FROM-THE-EARTH/NSE2020_10th/EAGLE/projects/NSE2020_1.brd

## EAGLE design EAGLE/projects/NSE2020_1.brd (2020-06-14)

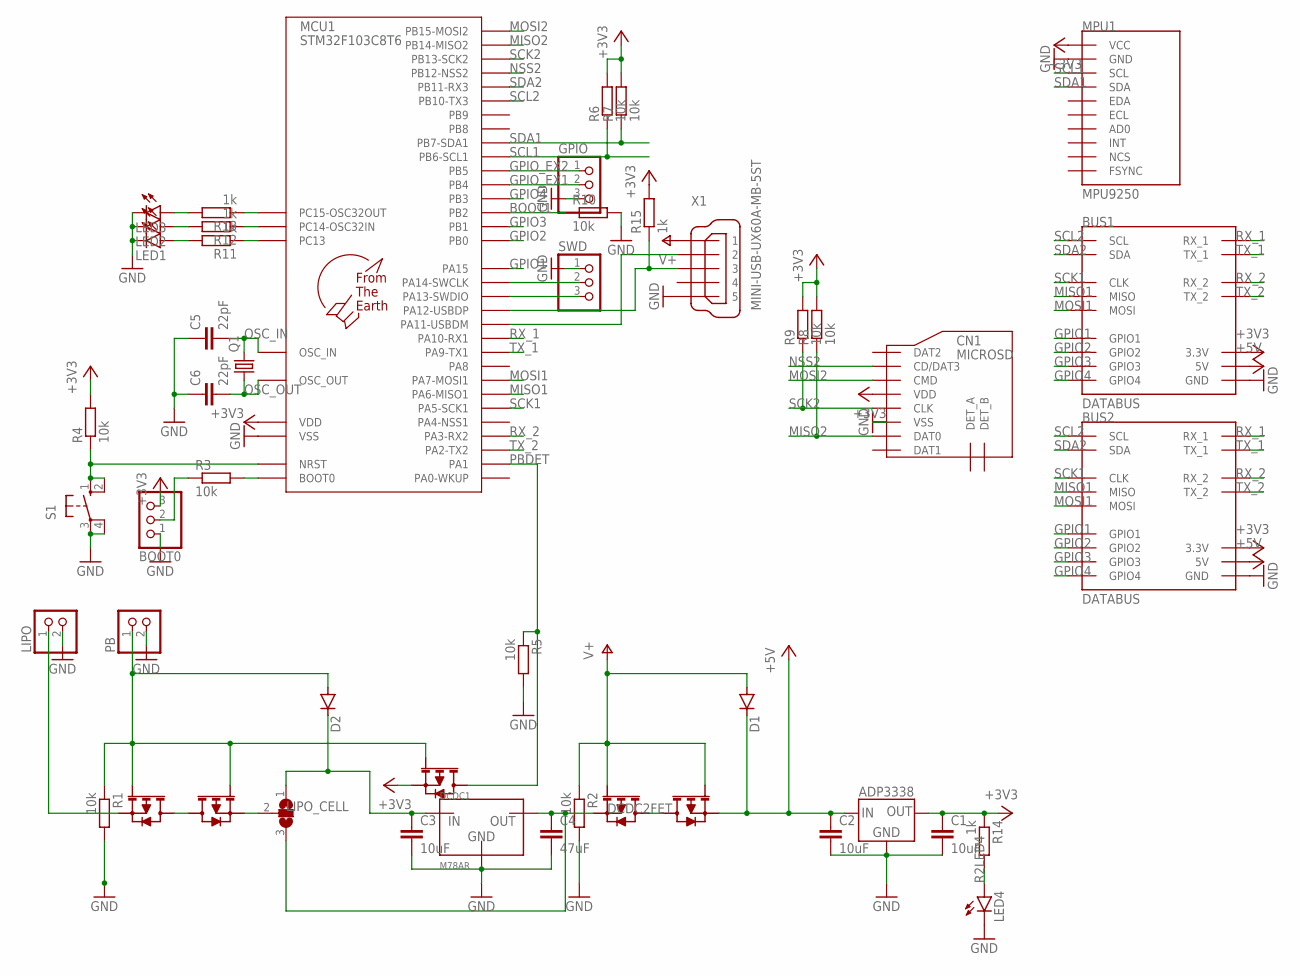
[picture p11: schematic NSE2020_1.sch]

Parts:
BOOT0: PINHD-1X3; 1X03
BUS1, BUS2: DATABUS; 8X2
C1, C2, C3: 10uF; C2012
C4: 47uF; C2012
C5, C6: 22pF; C2012
CN1: MICROSD; DM3AT
D1, D2: DIODE-SOD123; SOD123
DCDC1: M78AR
FET1, FET2, FET3, FET4, FET5: 2SJ681
GPIO: PINHD-1X3; 1X03
IC1: ADP3338-3.3; SOT-223
LED1, LED2, LED3, LED4: LEDSML0805; SML0805
LIPO: PINHD-1X2; 1X02
LIPO_CELL: SJ2W; SJ_2
MCU1: STM32F103C8T6; LQFP48
MPU1: MPU9250; GY-9250
PB: PINHD-1X2; 1X02
Q1: CRYSTALHC49S; HC49/S
R1, R2, R3, R4, R5, R6, R7, R8, R9, R10: 10k; M2012
R11, R12, R13, R14, R15: 1k; M2012
S1: 10-XX; B3F-10XX
SWD: PINHD-1X3; 1X03
U$1: F.T.E.LOGO; LOGO
X1: MINI-USB-UX60A-MB-5ST; UX60A-MB-5ST

Connections:
+3V3: BOOT0.3, BUS1.P6 (3.3V), BUS2.P6 (3.3V), C1.1, CN1.VDD, FET5.P$3, IC1.1 (OUT), IC1.2 (OUT), MCU1.1 (VDD), MCU1.9 (VDD), MCU1.24 (VDD), MCU1.36 (VDD), MCU1.48 (VDD), MPU1.P1 (VCC), R4.2, R6.2, R7.2, R8.2, R9.2, R14.1, R15.2
+5V: BUS1.P7 (5V), BUS2.P7 (5V), C2.1, D1.C, FET4.P$3, IC1.3 (IN)
BAT2DCDC: C3.1, D2.C, DCDC1.P1 (IN), LIPO_CELL.1
BOOT0: BOOT0.2, R3.1
BOOT0_R: MCU1.44 (BOOT0), R3.2
BOOT1: MCU1.20 (PB2), R10.1
DCDC2FET: C4.1, DCDC1.P3 (OUT), FET3.P$3, LIPO_CELL.3
DM: MCU1.32 (PA11-USBDM), X1.2
DP: MCU1.33 (PA12-USBDP), R15.1, X1.3
FET2FET: FET3.P$2, FET3.P$4, FET4.P$2, FET4.P$4
FET2JUMP: FET2.P$3, LIPO_CELL.2
GND: BOOT0.1, BUS1.P11 (GND), BUS2.P11 (GND), C1.2, C2.2, C3.2, C4.2, C5.1, C6.1, CN1.VSS, DCDC1.P2 (GND), GPIO.3, IC1.4 (GND), LED1.C, LED2.C, LED3.C, LED4.C, LIPO.2, MCU1.8 (VSS), MCU1.23 (VSS), MCU1.35 (VSS), MCU1.47 (VSS), MPU1.P2 (GND), PB.2, R1.2, R2.2, R5.2, R10.2, S1.3, S1.4 (P1), SWD.1, X1.5
GPIO1: BUS1.P3 (GPIO1), BUS2.P3 (GPIO1), MCU1.38 (PA15)
GPIO2: BUS1.P10 (GPIO2), BUS2.P10 (GPIO2), MCU1.18 (PB0)
GPIO3: BUS1.P14 (GPIO3), BUS2.P14 (GPIO3), MCU1.19 (PB1)
GPIO4: BUS1.P15 (GPIO4), BUS2.P15 (GPIO4), MCU1.39 (PB3)
GPIO_EX1: GPIO.2, MCU1.40 (PB4)
GPIO_EX2: GPIO.1, MCU1.41 (PB5)
IO2R1: MCU1.2 (PC13), R11.1
IO2R2: MCU1.3 (PC14-OSC32IN), R12.1
IO2R3: MCU1.4 (PC15-OSC32OUT), R13.1
LIPOIN: FET1.P$3, LIPO.1
LIPO_FET2FET: FET1.P$2, FET1.P$4, FET2.P$2, FET2.P$4
MISO1: BUS1.P12 (MISO), BUS2.P12 (MISO), MCU1.16 (PA6-MISO1)
MISO2: CN1.DAT0, MCU1.27 (PB14-MISO2), R8.1
MOSI1: BUS1.P2 (MOSI), BUS2.P2 (MOSI), MCU1.17 (PA7-MOSI1)
MOSI2: CN1.CMD, MCU1.28 (PB15-MOSI2)
NRST: MCU1.7 (NRST), R4.1, S1.1 (S), S1.2 (S1)
NSS2: CN1.CD/DAT3, MCU1.25 (PB12-NSS2)
OSC_IN: C5.2, MCU1.5 (OSC_IN), Q1.2
OSC_OUT: C6.2, MCU1.6 (OSC_OUT), Q1.1
PBDET: FET5.P$2, FET5.P$4, MCU1.11 (PA1), R5.1
PBIN: D2.A, FET1.P$1, FET2.P$1, FET5.P$1, PB.1, R1.1
R2LED1: LED1.A, R11.2
R2LED2: LED2.A, R12.2
R2LED3: LED3.A, R13.2
R2LED4: LED4.A, R14.2
RX_1: BUS1.P4 (RX_1), BUS2.P4 (RX_1), MCU1.31 (PA10-RX1)
RX_2: BUS1.P9 (RX_2), BUS2.P9 (RX_2), MCU1.13 (PA3-RX2)
SCK1: BUS1.P1 (CLK), BUS2.P1 (CLK), MCU1.15 (PA5-SCK1)
SCK2: CN1.CLK, MCU1.26 (PB13-SCK2), R9.1
SCL1: MCU1.42 (PB6-SCL1), MPU1.P3 (SCL), R6.1
SCL2: BUS1.P0 (SCL), BUS2.P0 (SCL), MCU1.21 (PB10-TX3)
SDA1: MCU1.43 (PB7-SDA1), MPU1.P4 (SDA), R7.1
SDA2: BUS1.P13 (SDA), BUS2.P13 (SDA), MCU1.22 (PB11-RX3)
SWCLK: MCU1.37 (PA14-SWCLK), SWD.2
SWDIO: MCU1.34 (PA13-SWDIO), SWD.3
TX_1: BUS1.P5 (TX_1), BUS2.P5 (TX_1), MCU1.30 (PA9-TX1)
TX_2: BUS1.P8 (TX_2), BUS2.P8 (TX_2), MCU1.12 (PA2-TX2)
V+: D1.A, FET3.P$1, FET4.P$1, R2.1, X1.1

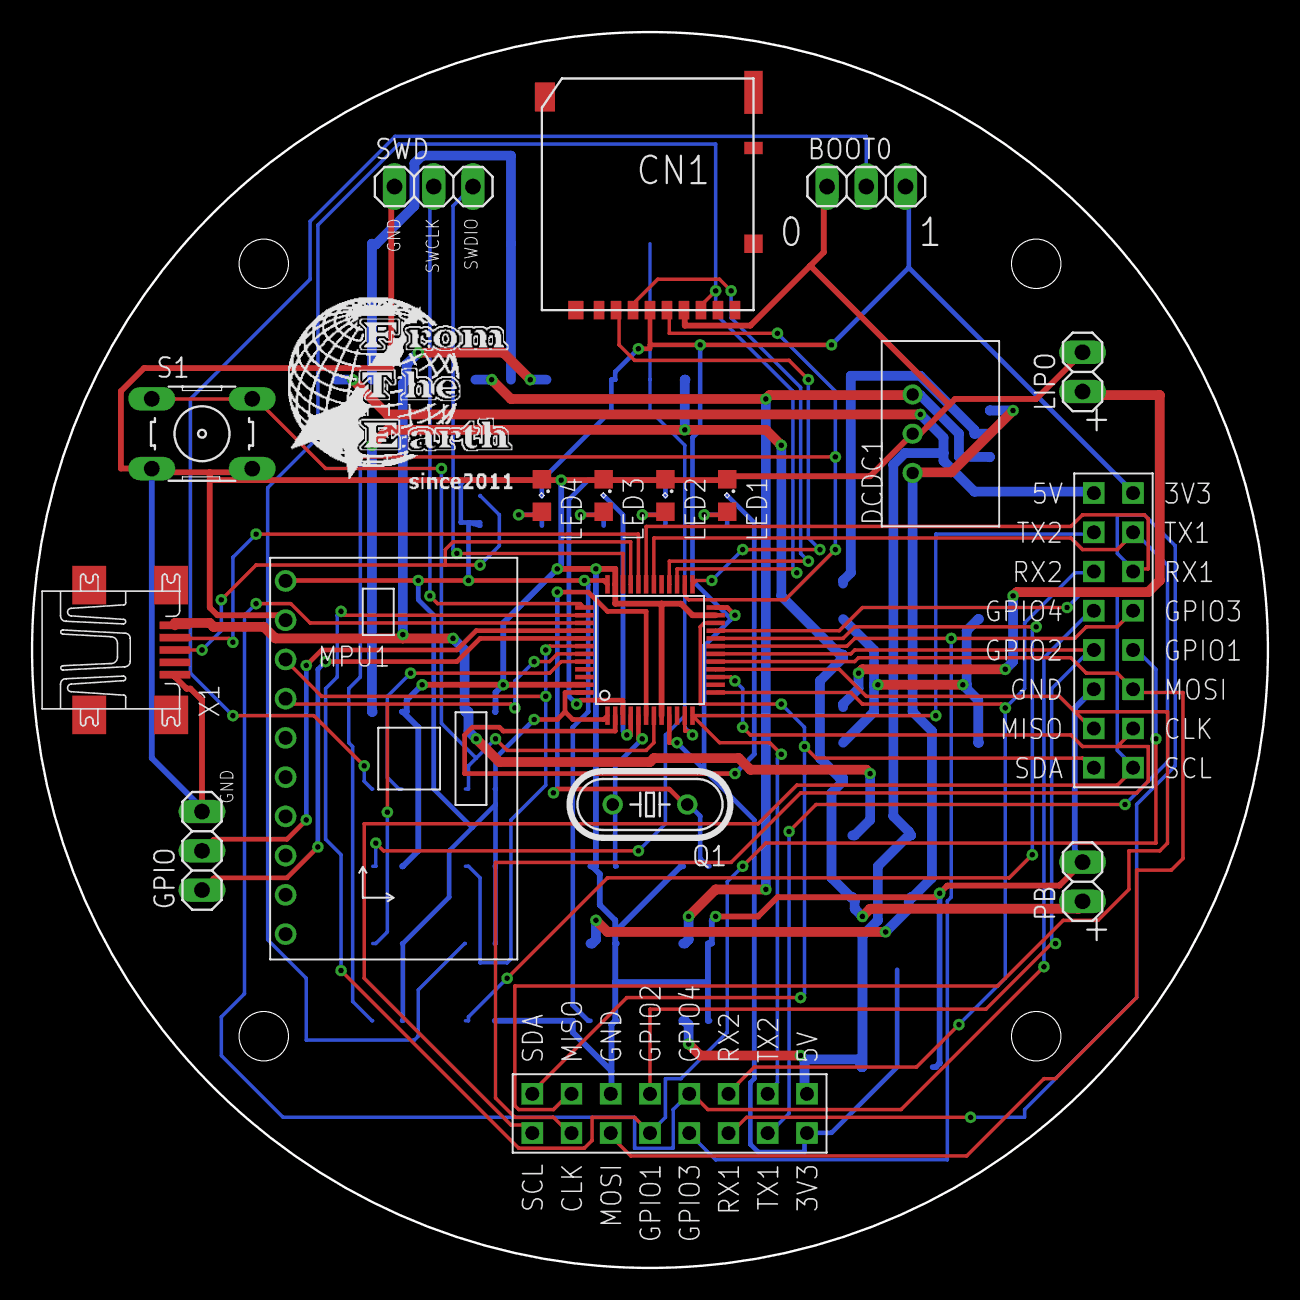
[picture p12: board NSE2020_1.brd from above]

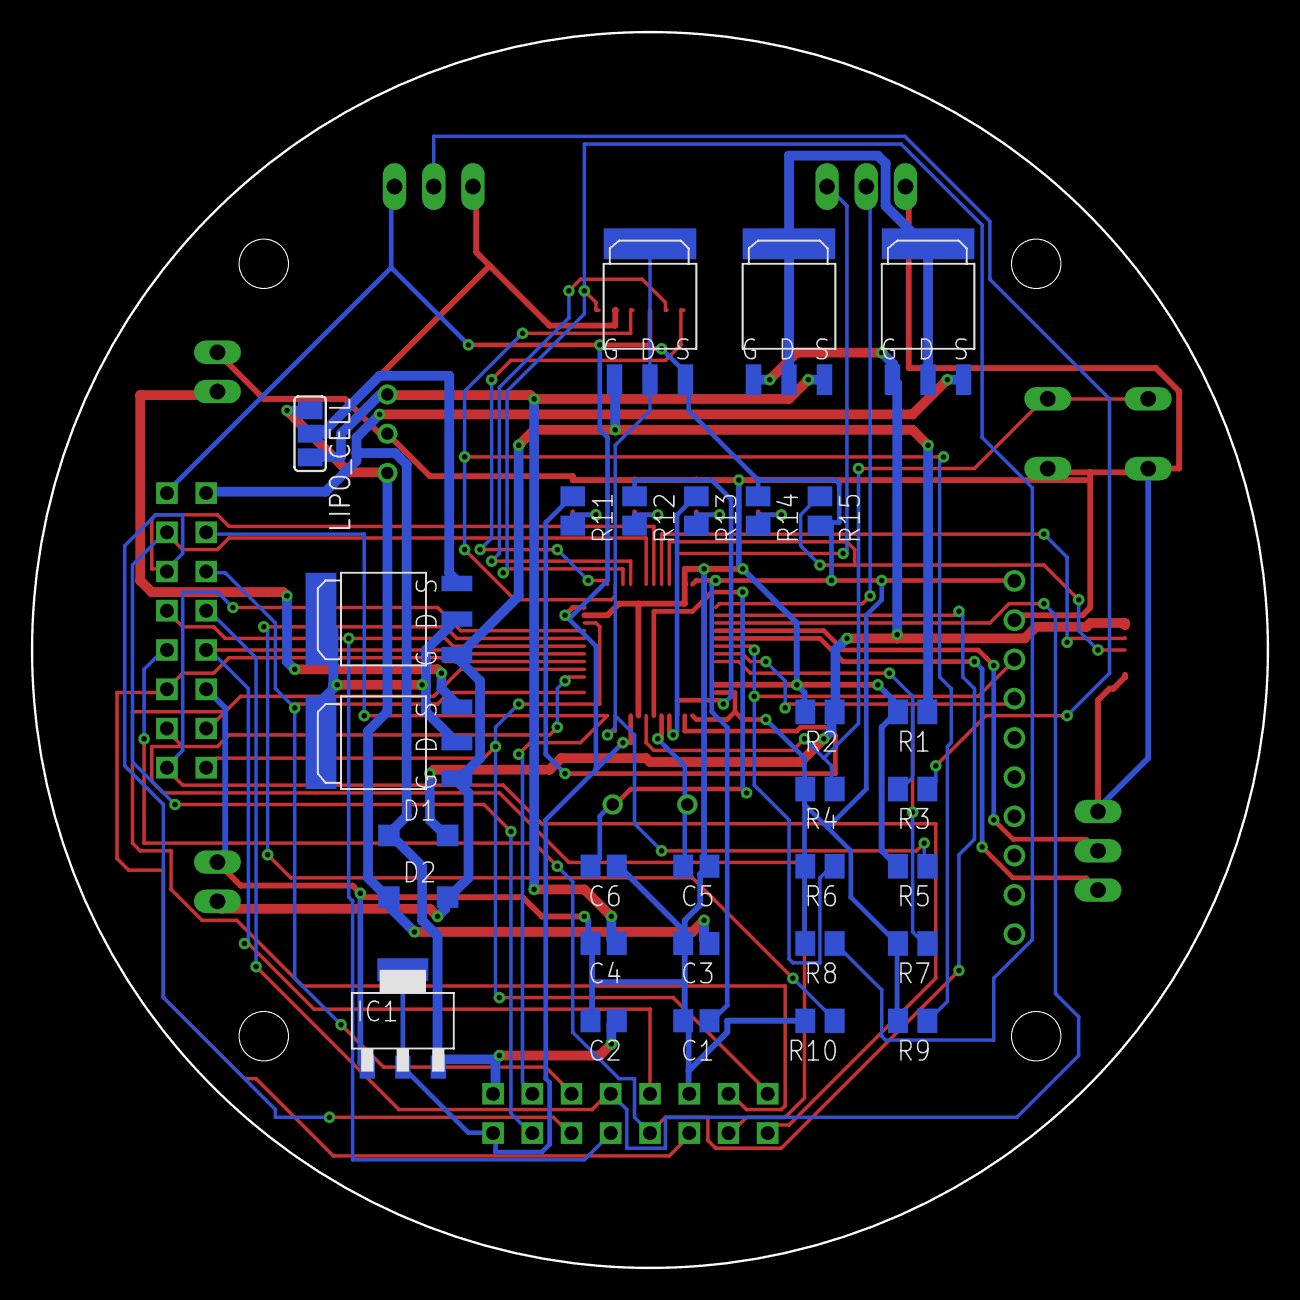
[picture p13: board NSE2020_1.brd from below]

Board: 2 copper layers, 80.0 x 80.0 mm, 49 parts (30 on the bottom side), 50 nets.
