FROM-THE-EARTH/NSE2020_10th/EAGLE/projects/NSE2020_2.brd

## EAGLE design EAGLE/projects/NSE2020_2.brd (2020-05-27)

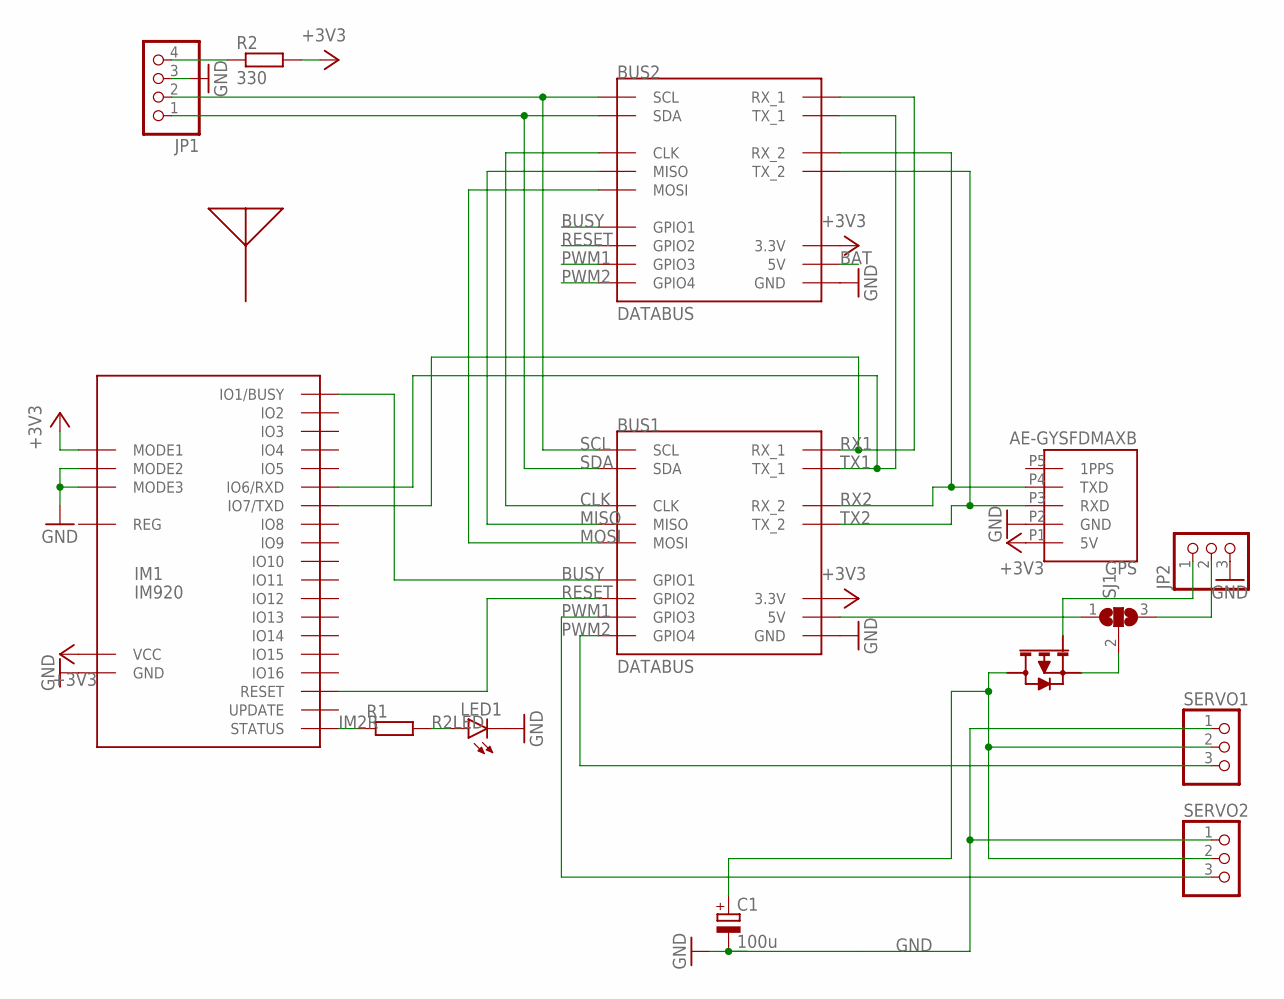
[picture p14: schematic NSE2020_2.sch]

Parts:
ANT1: IM920ANT-XS; ANTENNA
BUS1, BUS2: DATABUS; 8X2
C1: 100u; E2,5-6
GPS: AE-GYSFDMAXB
IM1: IM920
JP1: PINHD-1X4; 1X04
JP2: PINHD-1X3; 1X03
LED1: LEDSMT1206; 1206
R1: R-EU_M2012; M2012
R2: 330; R2012
SERVO1, SERVO2: PINHD-1X3; 1X03
SJ1: SJ2W; SJ_2
U$1: 2SJ681

Connections:
5V_CELL: BUS1.P7 (5V), SJ1.1
+3V3: BUS1.P6 (3.3V), BUS2.P6 (3.3V), GPS.P1 (5V), IM1.IO17 (MODE1), IM1.IO23 (VCC), R2.2
BAT: BUS2.P7 (5V), C1.+, SERVO1.2, SERVO2.2, U$1.P$2, U$1.P$4
BAT_CELL: JP2.2, SJ1.3
BUSY: BUS1.P3 (GPIO1), BUS2.P3 (GPIO1), IM1.IO1 (IO1/BUSY)
CLK: BUS1.P1 (CLK), BUS2.P1 (CLK)
GND: BUS1.P11 (GND), BUS2.P11 (GND), C1.-, GPS.P2 (GND), IM1.IO18 (MODE2), IM1.IO19 (MODE3), IM1.IO24 (GND), JP1.3, JP2.3, LED1.C, SERVO1.1, SERVO2.1
IM2R: IM1.IO21 (STATUS), R1.1
MISO: BUS1.P12 (MISO), BUS2.P12 (MISO)
MOSI: BUS1.P2 (MOSI), BUS2.P2 (MOSI)
unnamed: SJ1.2, U$1.P$3
unnamed: JP2.1, U$1.P$1
PWM1: BUS1.P14 (GPIO3), BUS2.P14 (GPIO3), SERVO2.3
PWM2: BUS1.P15 (GPIO4), BUS2.P15 (GPIO4), SERVO1.3
R2BMP: JP1.4, R2.1
R2LED: LED1.A, R1.2
RESET: BUS1.P10 (GPIO2), BUS2.P10 (GPIO2), IM1.IO25 (RESET)
RX1: BUS1.P4 (RX_1), BUS2.P4 (RX_1), IM1.IO7 (IO7/TXD)
RX2: BUS1.P9 (RX_2), BUS2.P9 (RX_2), GPS.P4 (TXD)
SCL: BUS1.P0 (SCL), BUS2.P0 (SCL), JP1.2
SDA: BUS1.P13 (SDA), BUS2.P13 (SDA), JP1.1
TX1: BUS1.P5 (TX_1), BUS2.P5 (TX_1), IM1.IO6 (IO6/RXD)
TX2: BUS1.P8 (TX_2), BUS2.P8 (TX_2), GPS.P3 (RXD)

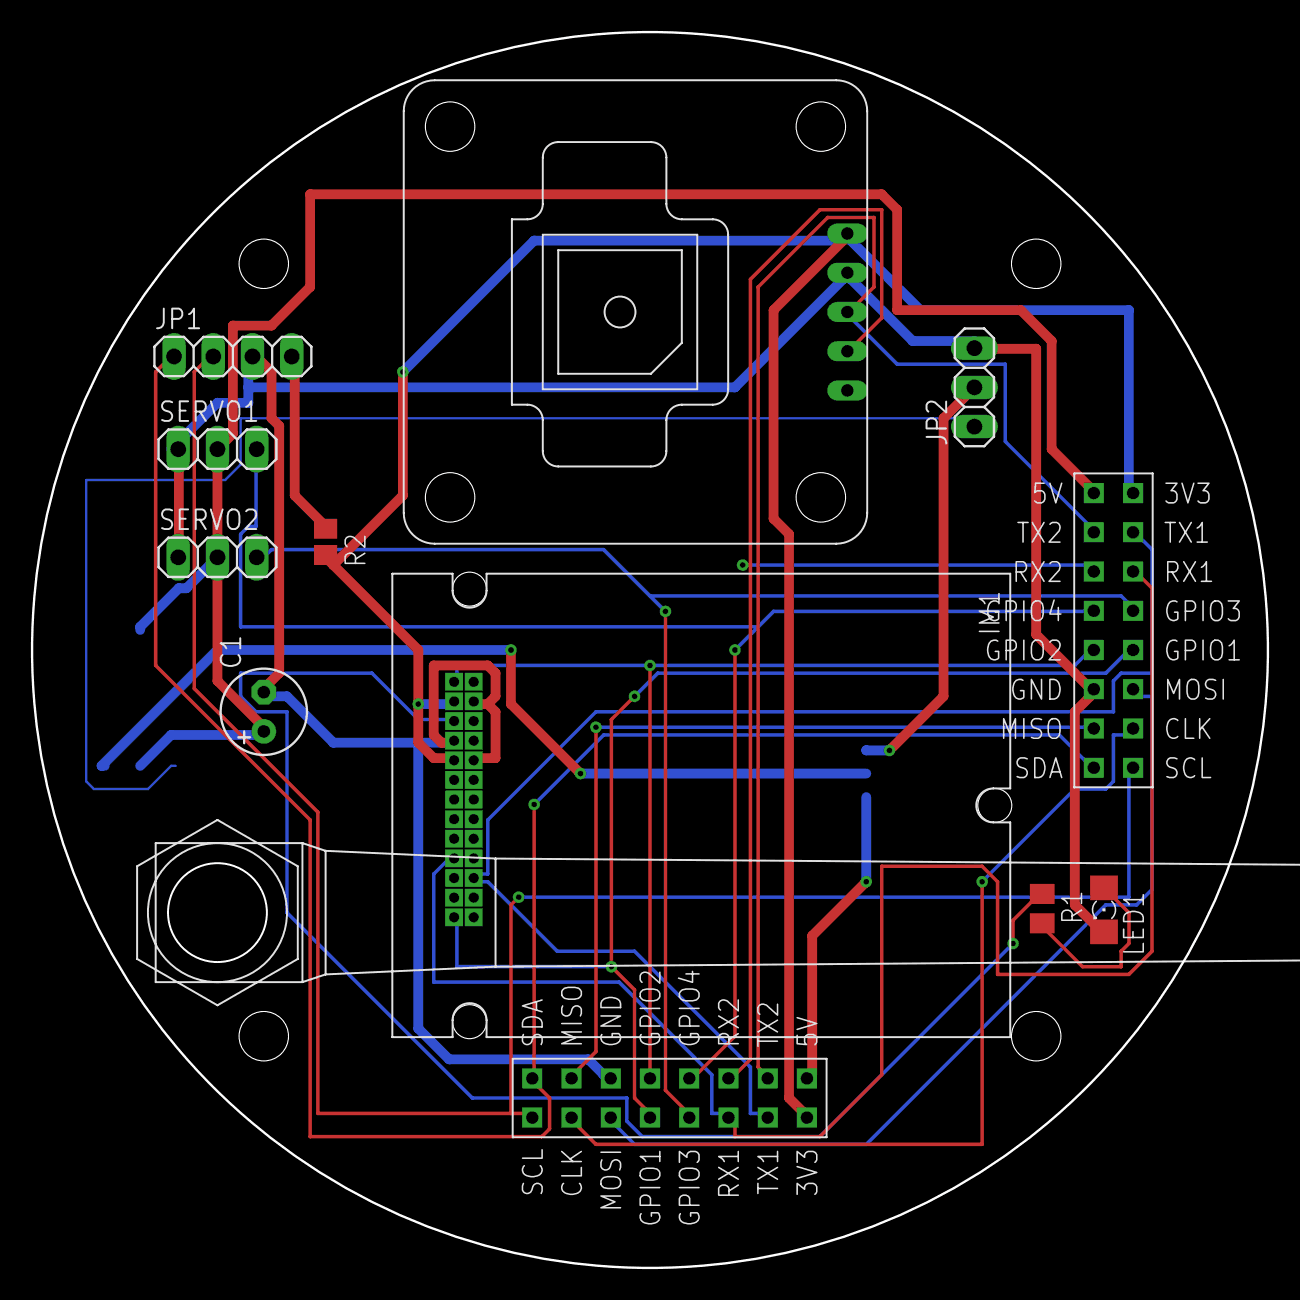
[picture p15: board EAGLE/projects/NSE2020_2.brd from above]

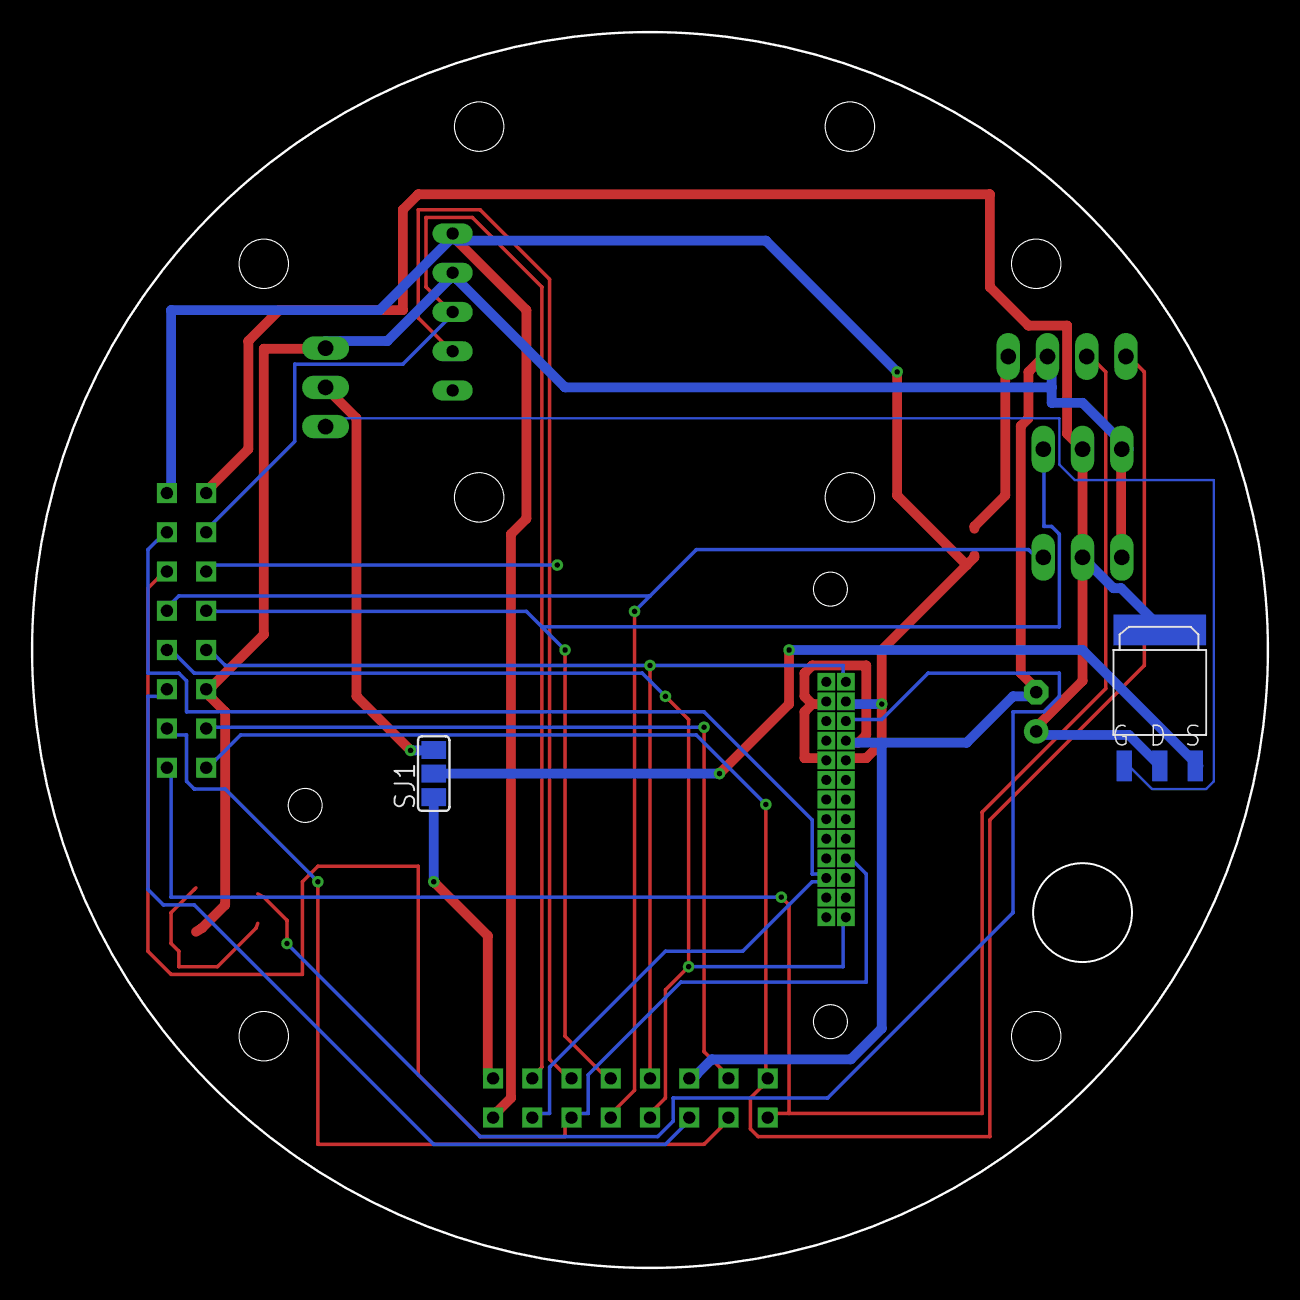
[picture p16: board EAGLE/projects/NSE2020_2.brd from below]

Board: 2 copper layers, 80.0 x 80.0 mm, 15 parts (2 on the bottom side), 23 nets.
