FROM-THE-EARTH/NSE2020_10th/EAGLE/NSE2020_2.brd

## EAGLE design EAGLE/NSE2020_2.brd (2020-03-19)

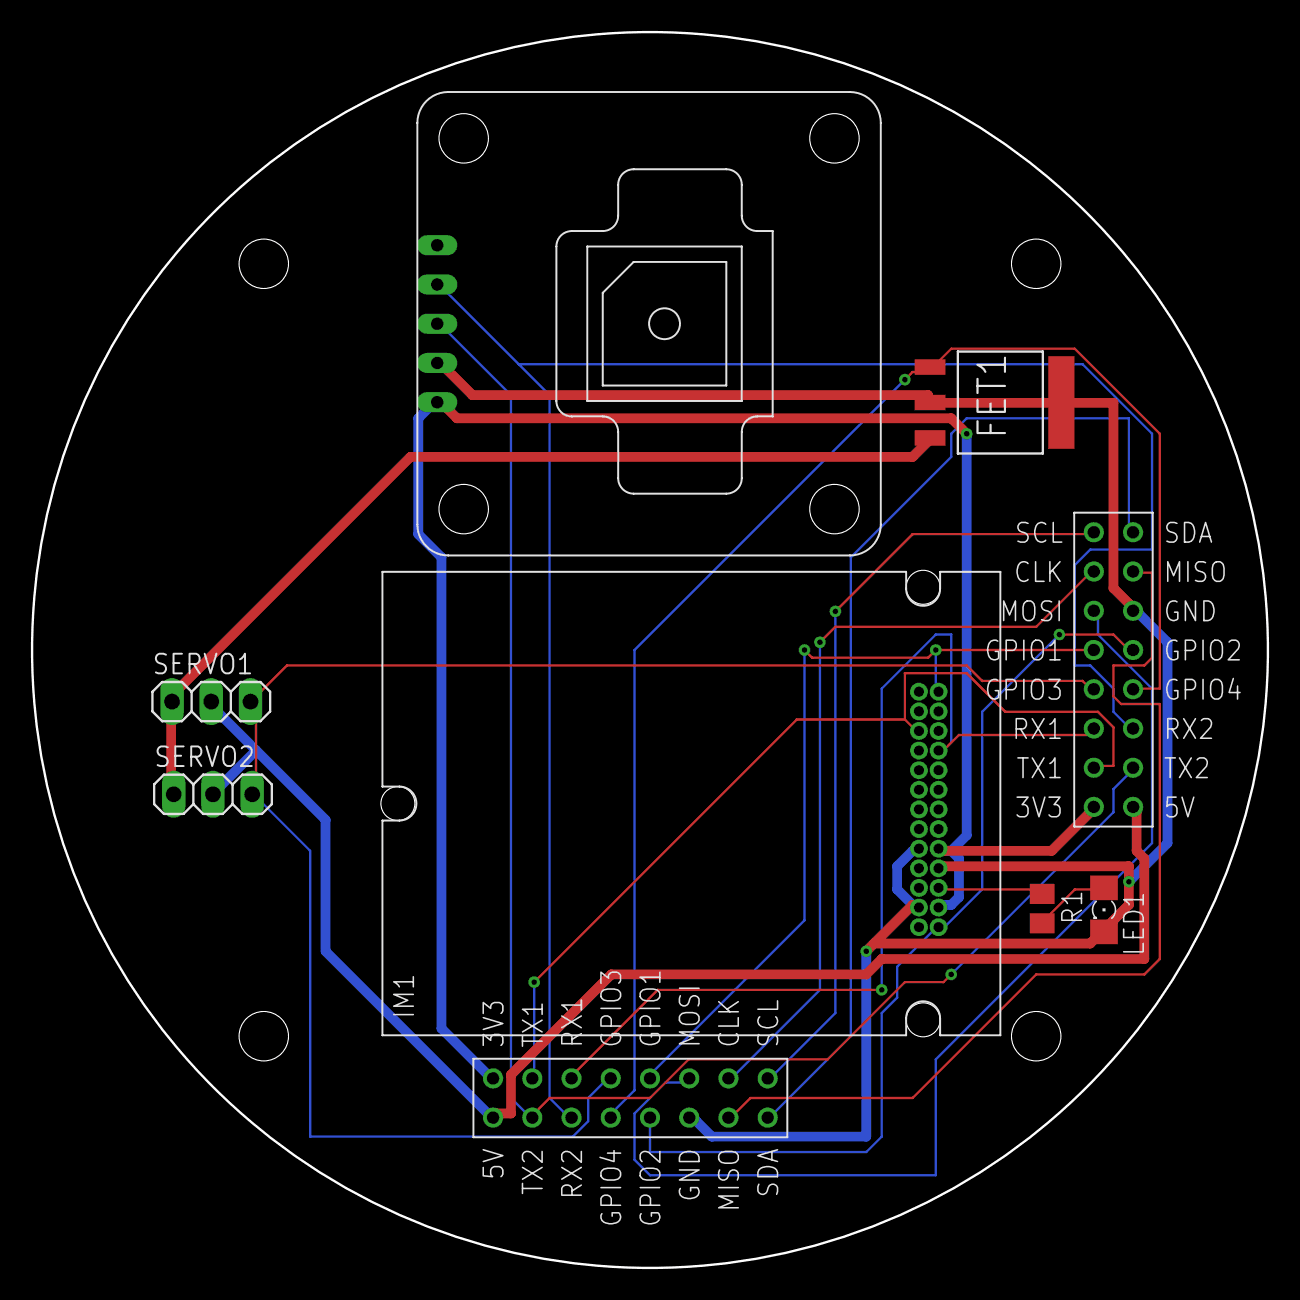
[picture p17: board EAGLE/NSE2020_2.brd from above]

Board: 2 copper layers, 80.0 x 80.0 mm, 9 parts (0 on the bottom side), 19 nets.

Parts:
BUS1, BUS2: DATABUS; 8X2
FET1: 2SK4033
GPS: AE-GYSFDMAXB
IM1: IM920
LED1: 1206
R1: M2012
SERVO1, SERVO2: 1X03

Connections:
+3V3: BUS1.P6, BUS2.P6, GPS.P1, IM1.IO2, IM1.IO5
BAT: BUS1.P7, BUS2.P7, SERVO1.2, SERVO2.2
BUSY: BUS1.P3, BUS2.P3, IM1.IO13
GND: BUS1.P11, BUS2.P11, FET1.P$1, FET1.P$2, GPS.P2, IM1.IO4, IM1.IO22, IM1.IO25, LED1.C
GND2FET: FET1.P$4, SERVO1.1, SERVO2.1
IM2R: IM1.IO3, R1.1
unnamed: BUS1.P0, BUS2.P0
unnamed: BUS1.P13, BUS2.P13
unnamed: BUS1.P1, BUS2.P1
unnamed: BUS1.P12, BUS2.P12
unnamed: BUS1.P2, BUS2.P2
PWM: BUS1.P14, BUS2.P14, SERVO1.3, SERVO2.3
R2LED: LED1.A, R1.2
RESET: BUS1.P10, BUS2.P10, IM1.IO1
RX1: BUS1.P5, BUS2.P5, IM1.IO16
RX2: BUS1.P8, BUS2.P8, GPS.P3
SERVOGATE: BUS1.P15, BUS2.P15, FET1.P$3
TX1: BUS1.P4, BUS2.P4, IM1.IO10
TX2: BUS1.P9, BUS2.P9, GPS.P4
