FROM-THE-EARTH/NSE2020_10th/soft/MPU9250.c

#include "MPU9250.h"

float accRange;
float gyroRange;
float mAdjx;
float mAdjy;
float mAdjz;

bool MPU9250_Initialize(int AccelScale, int GyroScale, int MagnetRate){
	uint8_t tempRegVal;
	I2cInitialize();
	tempRegVal = I2cReadByte(MPU9250_ADDRESS, MPU9250_WHO_AM_I);
	if(tempRegVal != MPU9250_WHO_AM_I_DEFAULT && tempRegVal != MPU9255_WHO_AM_I_DEFAULT)return false;

	I2cWriteByte(MPU9250_ADDRESS, MPU9250_PWR_MGMT_1, 0);				 //スリープモードを解除
	switch (AccelScale)
	{
	case 2:
		tempRegVal = MPU9250_ACCEL_FS_SEL_2G;
		accRange = 2.0;												 //計算で使用するので，選択したレンジを入力する
		break;
	case 4:
		tempRegVal = MPU9250_ACCEL_FS_SEL_4G;
		accRange = 4.0;
		break;
	case 8:
		tempRegVal = MPU9250_ACCEL_FS_SEL_8G;
		accRange = 8.0;
		break;
	default:
		tempRegVal = MPU9250_ACCEL_FS_SEL_16G;
		accRange = 16.0;
		break;
	}
	I2cWriteByte(MPU9250_ADDRESS, MPU9250_ACCEL_CONFIG, tempRegVal);		 //加速度センサの測定レンジの設定

	switch (GyroScale)
	{
	case 250:
		tempRegVal = MPU9250_GYRO_FS_SEL_250DPS;
		gyroRange = 250.0;												 //計算で使用するので，選択したレンジを入力する
		break;
	case 500:
		tempRegVal = MPU9250_GYRO_FS_SEL_500DPS;
		gyroRange = 500.0;
		break;
	case 1000:
		tempRegVal = MPU9250_GYRO_FS_SEL_1000DPS;
		gyroRange = 1000.0;
		break;
	default:
		tempRegVal = MPU9250_GYRO_FS_SEL_2000DPS;
		gyroRange = 2000.0;
		break;
	}
	I2cWriteByte(MPU9250_ADDRESS, MPU9250_GYRO_CONFIG, tempRegVal); //ジャイロセンサの測定レンジの設定

	accRange /= 32768.0;	//計算用の係数に変換
	gyroRange /= 32768.0;

	I2cWriteByte(MPU9250_ADDRESS, MPU9250_INT_PIN_CFG, 0x02);				 //bypass mode(磁気センサが使用出来るようになる)
	for(uint64_t i = 0;i < 0xFFFF;i++);

	tempRegVal = I2cReadByte(AK8963_ADDRESS, AK8963_WIM);
	if(tempRegVal != AK8963_WHI_DEFAULT)return false;

	switch (MagnetRate)
	{
	case 8:
		tempRegVal = AK8963_CNTL1_MODE_SEL_8HZ;
		break;
	default:
		tempRegVal = AK8963_CNTL1_MODE_SEL_100HZ;
		break;
	}
	I2cWriteByte(AK8963_ADDRESS, AK8963_CNTL1, tempRegVal);
	uint8_t asax = I2cReadByte(AK8963_ADDRESS, AK8963_ASAX);
	uint8_t asay = I2cReadByte(AK8963_ADDRESS, AK8963_ASAY);
	uint8_t asaz = I2cReadByte(AK8963_ADDRESS, AK8963_ASAZ);

	mAdjx = ((float)asax - 128.0f) * 0.5f / 128.0f + 1.0f;
	mAdjy = ((float)asay - 128.0f) * 0.5f / 128.0f + 1.0f;
	mAdjz = ((float)asaz - 128.0f) * 0.5f / 128.0f + 1.0f;

	mAdjx *= 4921.0f / 32768.0f;	//計算用の係数に変換
	mAdjy *= 4921.0f / 32768.0f;	//計算用の係数に変換
	mAdjz *= 4921.0f / 32768.0f;	//計算用の係数に変換

	return true;
}

void MPU9250_ReadAccGyr(float *ax, float *ay, float *az, float *gx, float *gy, float *gz){
	uint8_t AccGyroTemp[14];
	I2cReadBytes(MPU9250_ADDRESS, MPU9250_ACCEL_XOUT_H, AccGyroTemp, 14);
	*ax = (int16_t)(AccGyroTemp[0] << 8 | AccGyroTemp[1]) * accRange;
	*ay = (int16_t)(AccGyroTemp[2] << 8 | AccGyroTemp[3]) * accRange;
	*az = (int16_t)(AccGyroTemp[4] << 8 | AccGyroTemp[5]) * accRange;

	*gx = (int16_t)(AccGyroTemp[8] << 8 | AccGyroTemp[9]) * gyroRange;
	*gy = (int16_t)(AccGyroTemp[10] << 8 | AccGyroTemp[11]) * gyroRange;
	*gz = (int16_t)(AccGyroTemp[12] << 8 | AccGyroTemp[13]) * gyroRange;
}

void MPU9250_ReadAcc(float *ax, float *ay, float *az){
	uint8_t AccTemp[6];
	I2cReadBytes(MPU9250_ADDRESS, MPU9250_ACCEL_XOUT_H, AccTemp, 6);
	*ax = (int16_t)(AccTemp[0] << 8 | AccTemp[1]) * accRange;
	*ay = (int16_t)(AccTemp[2] << 8 | AccTemp[3]) * accRange;
	*az = (int16_t)(AccTemp[4] << 8 | AccTemp[5]) * accRange;
}
void MPU9250_ReadGyr(float *gx, float *gy, float *gz){
	uint8_t GyroTemp[6];
	I2cReadBytes(MPU9250_ADDRESS, MPU9250_GYRO_XOUT_H, GyroTemp, 6);
	*gx = (int16_t)(GyroTemp[0] << 8 | GyroTemp[1]) * gyroRange;
	*gy = (int16_t)(GyroTemp[2] << 8 | GyroTemp[3]) * gyroRange;
	*gz = (int16_t)(GyroTemp[4] << 8 | GyroTemp[5]) * gyroRange;
}

bool MPU9250_ReadMag(float *mx, float *my, float *mz){
	uint8_t ST1Bit;
	ST1Bit = I2cReadByte(AK8963_ADDRESS, AK8963_ST1);
	if ((ST1Bit & 0x01)){
		uint8_t magneticData[7];
		I2cReadBytes(AK8963_ADDRESS, AK8963_HXL, magneticData, 7);
		*mx = ((int16_t)((magneticData[3] << 8) | magneticData[2])) * mAdjy;
		*my = ((int16_t)((magneticData[1] << 8) | magneticData[0])) * mAdjx;
		*mz = -((int16_t)((magneticData[5] << 8) | magneticData[4])) * mAdjz;
		return true;
	}else return false;
}
