FROM-THE-EARTH/NSE2020_10th/soft/SPIRawHandler.h

#ifndef INC_SPIRAWHANDLER_H_
#define INC_SPIRAWHANDLER_H_

#include "main.h"

void SpiInitialize();

void SpiRawWrite(uint8_t data);
uint8_t SpiRawRead();
void SpiRawWriteMulti(uint8_t *data,uint16_t count);
void SpiRawReadMulti(uint8_t *data,uint16_t count);

void SpiAsertSS();
void SpiDeAsertSS();

#endif /* INC_SPIRAWHANDLER_H_ */
