FROM-THE-EARTH/NSE2020_10th/(commit log)

2020-03-19 回路とライブラリ
    [NSE2020_1.brd, NSE2020_1.sch, NSE2020_2.brd, NSE2020_2.sch]
2020-03-19 ディレクトリ分け
    [NSE2020_1.brd, NSE2020_1.sch, NSE2020_2.brd, NSE2020_2.sch]
2020-03-19 ディレクトリの追加
    [NSE2020_1.brd, NSE2020_1.sch, NSE2020_2.brd, NSE2020_2.sch]
2020-03-20 camファイルとデザインルール等を追加
    [NSE2020_1.brd, NSE2020_1.sch]
2020-04-15 試作を基にした修正とアンテナ追加
2020-04-15 試作を基にした修正
    DPをプルアップ
    DAT0をプルアップ
    VBUSのFET2段化
    ダイオードの削除
    クリスタルの配線変更
    [NSE2020_1_2.brd, NSE2020_1_2.sch]
2020-04-16 ディレクトリ構成の変更
    [NSE2020_1.brd, NSE2020_1.sch, NSE2020_2.brd, NSE2020_2.sch]
2020-04-21 IM920修正
    [NSE2020_2.brd, NSE2020_2.sch]
2020-05-27 第2次試作で見つかったミスの修正
    [NSE2020_1.brd, NSE2020_1.sch, NSE2020_2.brd, NSE2020_2.sch]
2020-06-08 第3次試作を受けた修正
2020-06-14 第3次試作修正(USB抵抗、BOOT1プルダウン)
    [NSE2020_1.brd, NSE2020_1.sch]
2020-10-21 資料追加
